Jordaine777/ball-and-beam-pid/Plots/PID_output_kp+kd+ki.png

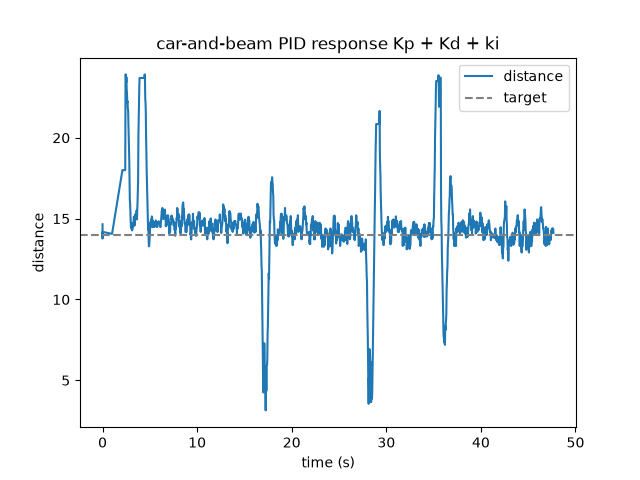
Plots/PID_output_kp+kd+ki.png
