Jordaine777/ball-and-beam-pid/Plots/PID_balance_beam_test_1_steady state error.png

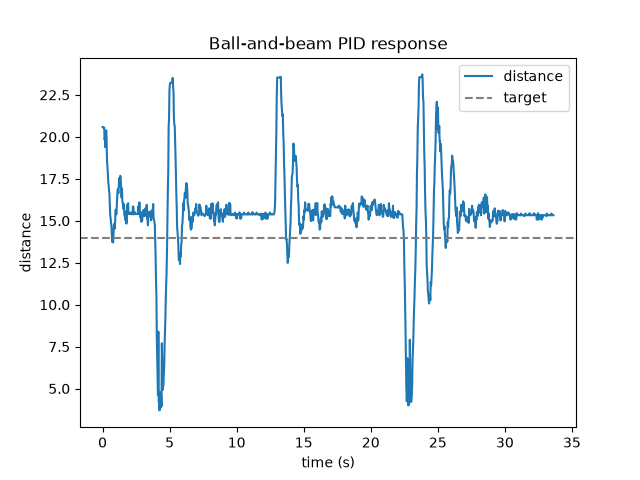
Plots/PID_balance_beam_test_1_steady state error.png
